dmarquez82/DCI-TP-INTEGRADOR/info/ESP32-S3-DevKitC 1 N16R8 PINOUT.jpg

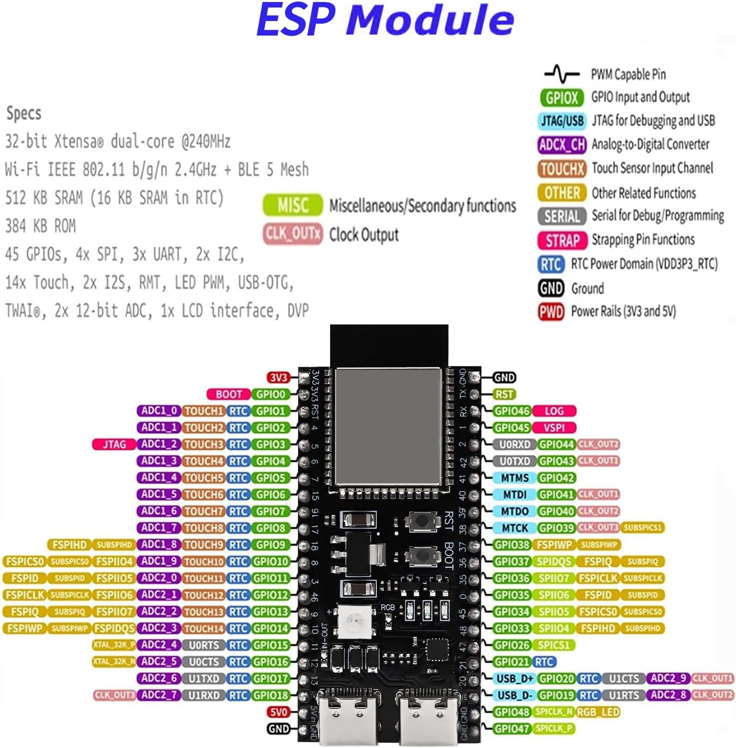
info/ESP32-S3-DevKitC 1 N16R8 PINOUT.jpg
