dmarquez82/DCI-TP-INTEGRADOR/pcb/Placa_Carrier_ESP32-S3-DEVKIT/3d/TerminalBlock_Phoenix_MKDS-1,5-3-5.08_1x03_P5.08mm_Horizontal.step

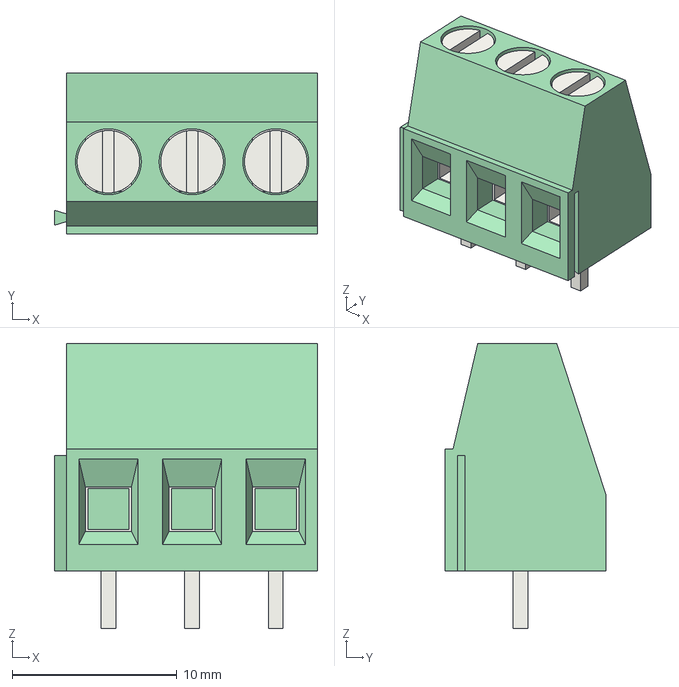
[picture p5: CAD file, 2026-11-07]
pcb/Placa_Carrier_ESP32-S3-DEVKIT/3d/TerminalBlock_Phoenix_MKDS-1,5-3-5.08_1x03_P5.08mm_Horizontal.step
16.0 x 9.80 x 17.3 mm
