dmarquez82/DCI-TP-INTEGRADOR/pcb/Placa_Carrier_ESP32-S3-DEVKIT/3d/C_0805_2012Metric.step

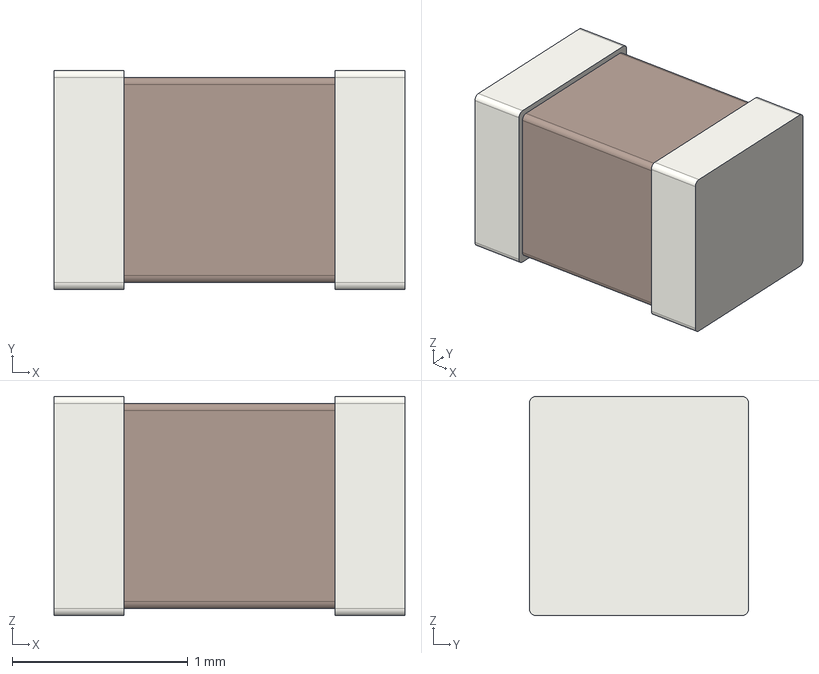
[picture p6: CAD file, 2026-11-07]
pcb/Placa_Carrier_ESP32-S3-DEVKIT/3d/C_0805_2012Metric.step
2.00 x 1.25 x 1.25 mm
