dmarquez82/DCI-TP-INTEGRADOR/pcb/Placa_Carrier_ESP32-S3-DEVKIT/3d/CP_Elec_6.3x7.7.step

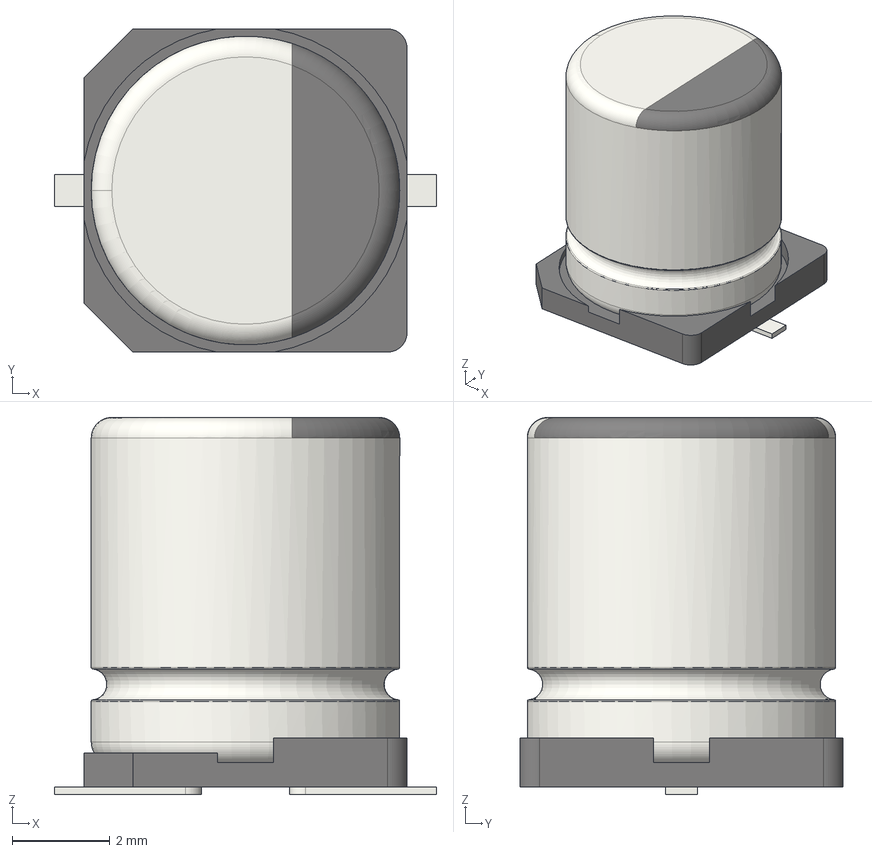
[picture p8: CAD file, 2026-11-07]
pcb/Placa_Carrier_ESP32-S3-DEVKIT/3d/CP_Elec_6.3x7.7.step
7.80 x 6.60 x 7.70 mm
