dmarquez82/DCI-TP-INTEGRADOR/pcb/Placa_Carrier_ESP32-S3-DEVKIT/3d/D_SOD-123.step

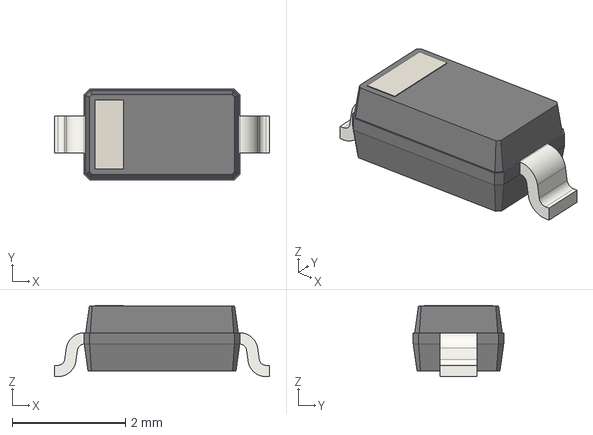
[picture p9: CAD file, 2026-11-07]
pcb/Placa_Carrier_ESP32-S3-DEVKIT/3d/D_SOD-123.step
3.80 x 1.60 x 1.26 mm
