dmarquez82/DCI-TP-INTEGRADOR/pcb/Placa_Carrier_ESP32-S3-DEVKIT/3d/TestPoint_Loop_D2.50mm_Drill1.0mm.step

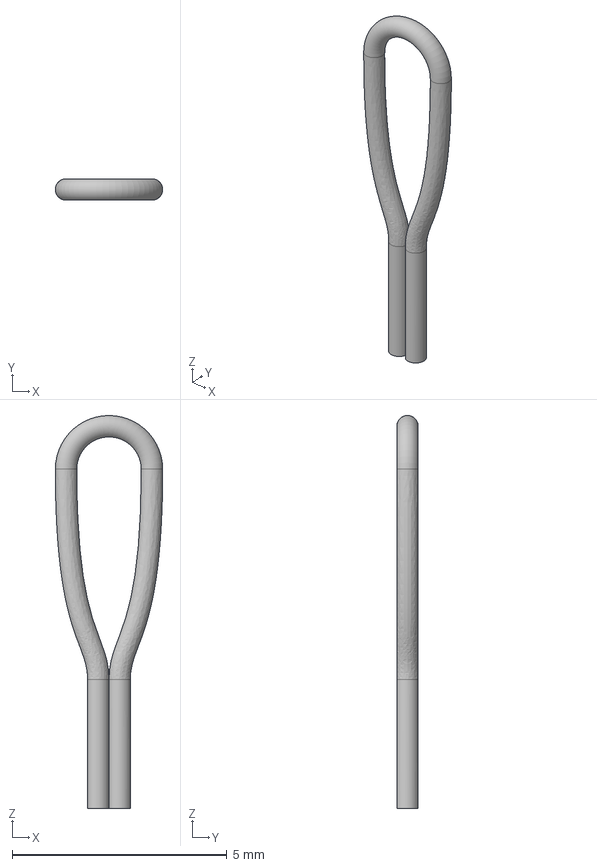
[picture p10: CAD file, 2026-11-07]
pcb/Placa_Carrier_ESP32-S3-DEVKIT/3d/TestPoint_Loop_D2.50mm_Drill1.0mm.step
2.50 x 0.5 x 9.15 mm
