dmarquez82/DCI-TP-INTEGRADOR/pcb/Placa_Carrier_ESP32-S3-DEVKIT/3d/PinHeader_1x02_P2.54mm_Vertical.step

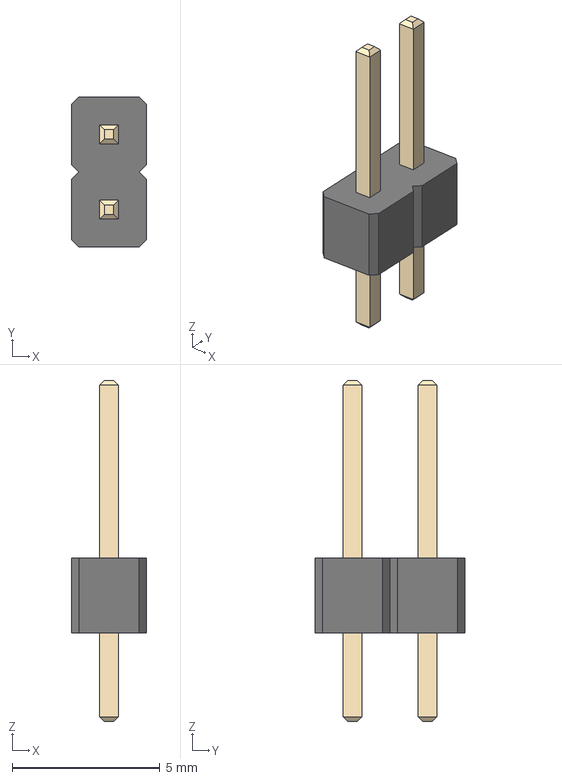
[picture p11: CAD file, 2026-11-07]
pcb/Placa_Carrier_ESP32-S3-DEVKIT/3d/PinHeader_1x02_P2.54mm_Vertical.step
2.54 x 5.08 x 11.5 mm
