dmarquez82/DCI-TP-INTEGRADOR/pcb/Placa_Carrier_ESP32-S3-DEVKIT/3d/CP_EIA-3528-21_Kemet-B.step

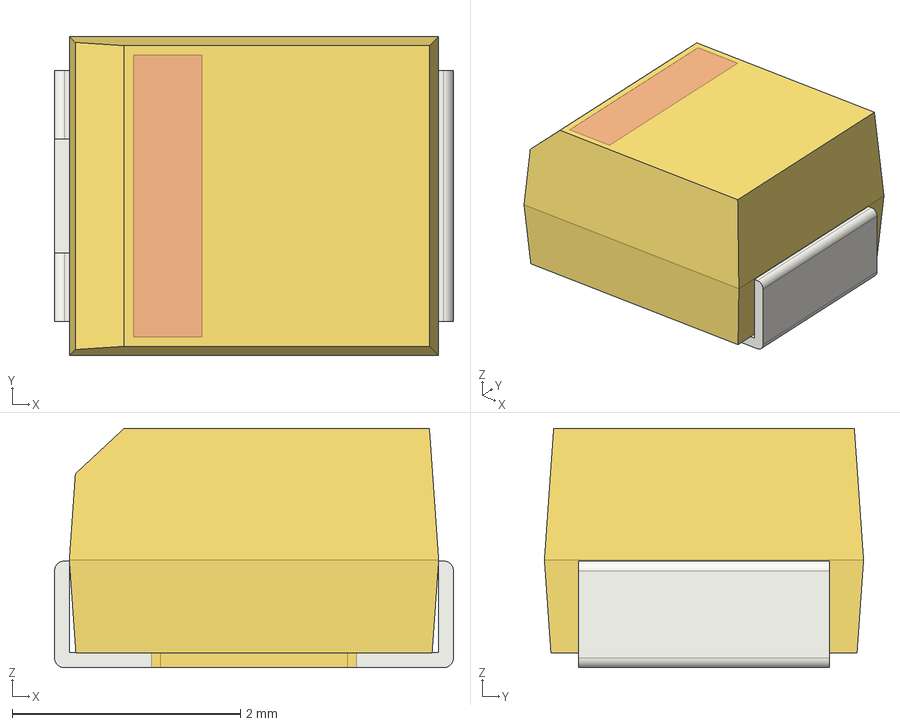
[picture p15: CAD file, 2026-11-07]
pcb/Placa_Carrier_ESP32-S3-DEVKIT/3d/CP_EIA-3528-21_Kemet-B.step
3.50 x 2.80 x 2.10 mm
