dmarquez82/DCI-TP-INTEGRADOR/pcb/Placa_Carrier_ESP32-S3-DEVKIT/3d/SW_PUSH_6mm.step

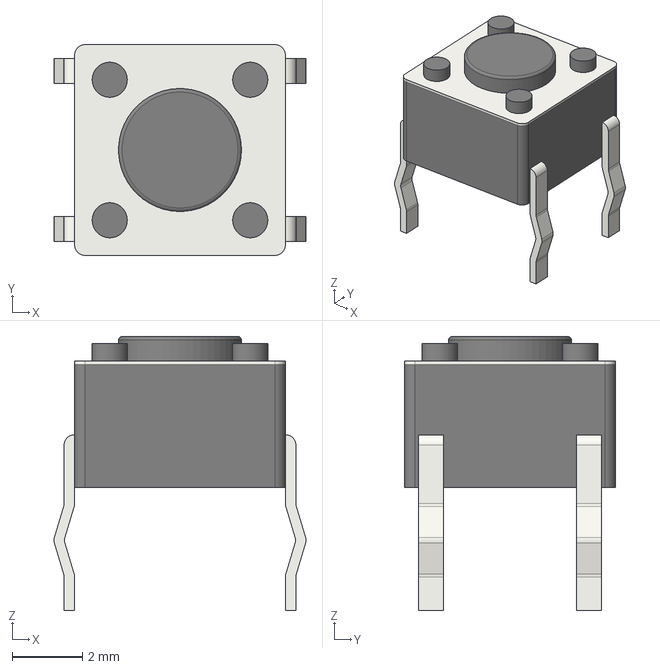
[picture p16: CAD file, 2026-11-07]
pcb/Placa_Carrier_ESP32-S3-DEVKIT/3d/SW_PUSH_6mm.step
7.17 x 6.00 x 7.80 mm
