dmarquez82/DCI-TP-INTEGRADOR/pcb/Placa_Carrier_ESP32-S3-DEVKIT/3d/R_1206_3216Metric.step

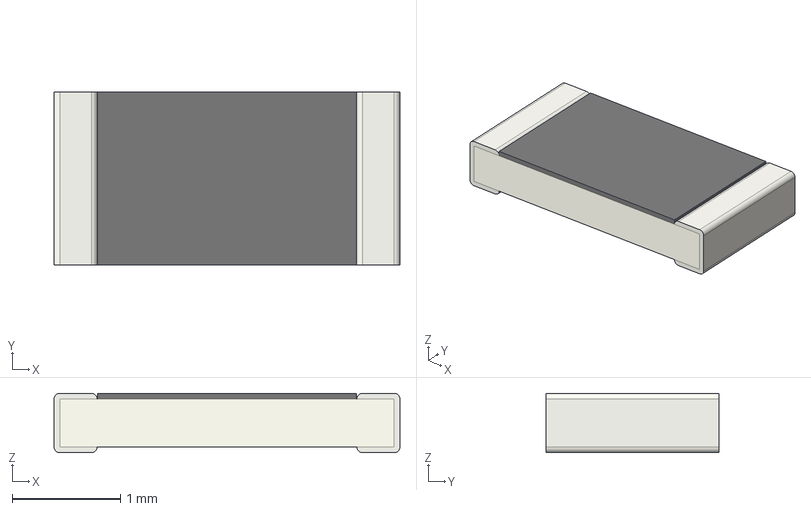
[picture p19: CAD file, 2026-11-07]
pcb/Placa_Carrier_ESP32-S3-DEVKIT/3d/R_1206_3216Metric.step
3.20 x 1.60 x 0.55 mm
