dmarquez82/DCI-TP-INTEGRADOR/pcb/Placa_Carrier_ESP32-S3-DEVKIT/3d/PinSocket_1x22_P2.54mm_Vertical.step

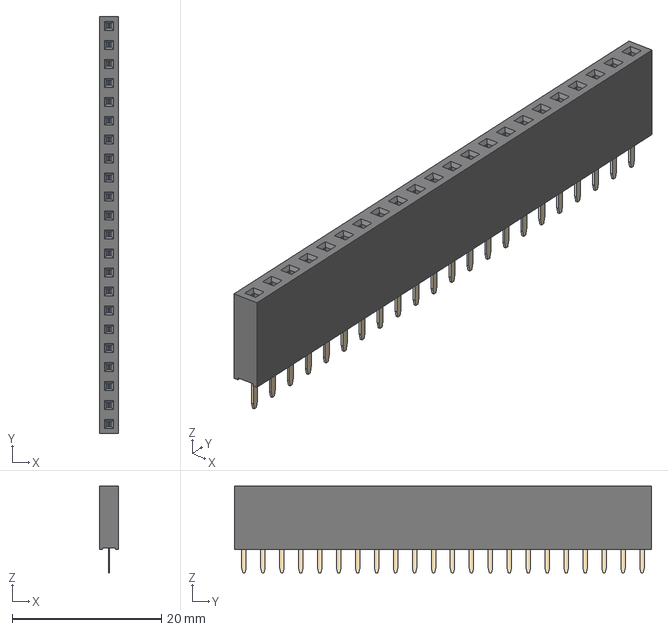
[picture p20: CAD file, 2026-11-07]
pcb/Placa_Carrier_ESP32-S3-DEVKIT/3d/PinSocket_1x22_P2.54mm_Vertical.step
2.54 x 55.9 x 11.6 mm
