dmarquez82/DCI-TP-INTEGRADOR/pcb/Placa_Carrier_ESP32-S3-DEVKIT/3d/Aosong_DHT11_5.5x12.0_P2.54mm.step

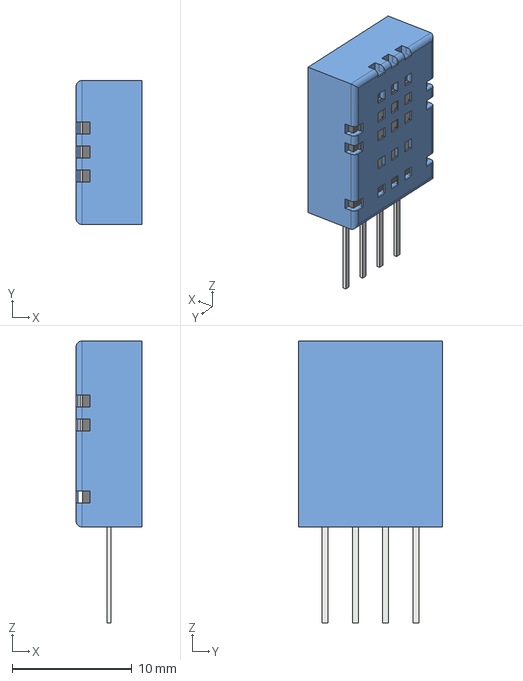
[picture p21: CAD file, 2026-11-07]
pcb/Placa_Carrier_ESP32-S3-DEVKIT/3d/Aosong_DHT11_5.5x12.0_P2.54mm.step
5.50 x 12.0 x 23.5 mm
