dmarquez82/DCI-TP-INTEGRADOR/pcb/Placa_Carrier_ESP32-S3-DEVKIT/3d/Relay_SPDT_SANYOU_SRD_Series_Form_C.step

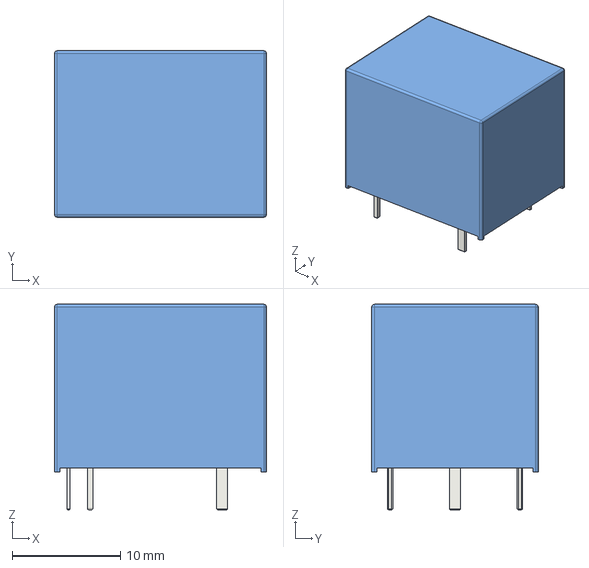
[picture p23: CAD file, 2026-11-07]
pcb/Placa_Carrier_ESP32-S3-DEVKIT/3d/Relay_SPDT_SANYOU_SRD_Series_Form_C.step
19.6 x 15.4 x 19.0 mm
