dmarquez82/DCI-TP-INTEGRADOR/info/PDF Kicad/Placa_Carrier_ESP32-S3-DEVKIT.pdf

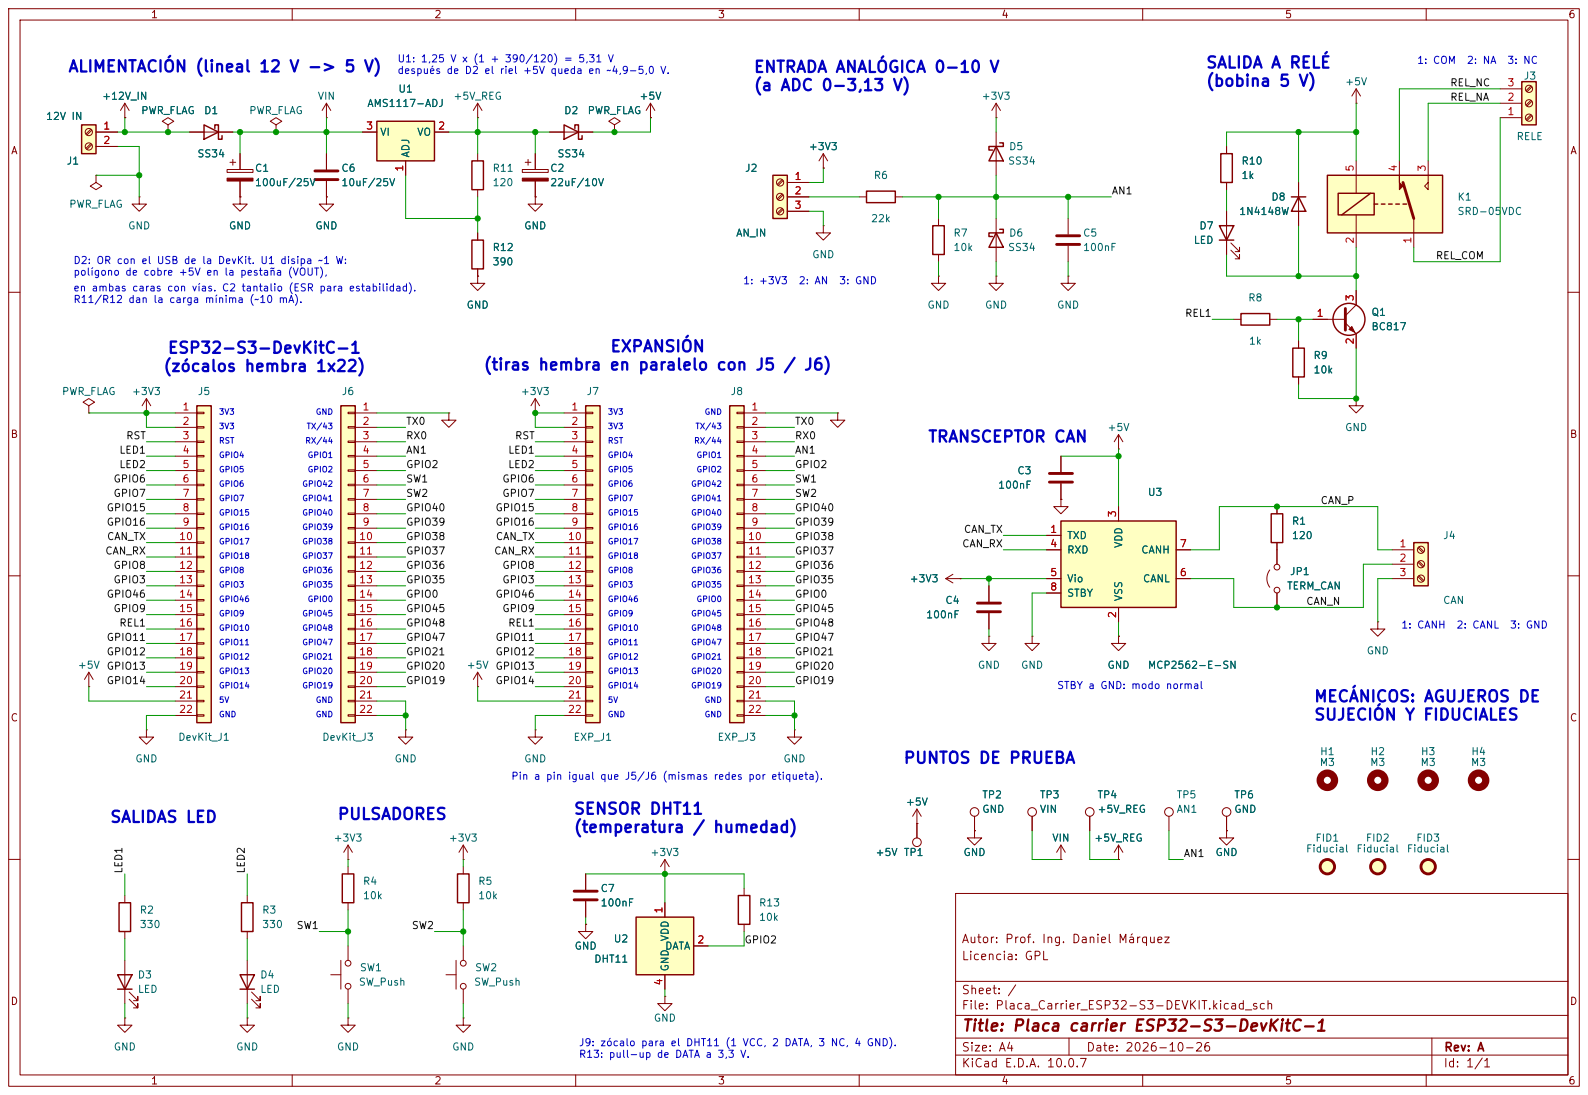
[picture p24: page 1]

U1: 1,25 V x (1 + 390/120) = 5,31 V después de D2 el riel +5V queda en ~4,9-5,0 V. EXPANSIÓN

TX/43 en ambas caras con vías. C2 tantalio (ESR para estabilidad).
R11/R12 dan la carga mínima (~10 mA).GPIO42 ESP32-S3-DevKitC-1

(tiras hembra en paralelo con J5 / J6)

GPIO14 Pin a pin igual que J5/J6 (mismas redes por etiqueta).

STBY a GND: modo normal PUNTOS DE PRUEBA

Autor: Prof. Ing. Daniel Márquez
Licencia: GPL

Sheet: /
File: Placa_Carrier_ESP32-S3-DEVKIT.kicad_sch
Title: Placa carrier ESP32-S3-DevKitC-1

J9: zócalo para el DHT11 (1 VCC, 2 DATA, 3 NC, 4 GND). R13: pull-up de DATA a 3,3 V.

Size: A4 | Rev: A
KiCad E.D.A. 10.0.7 | Id: 1/1
