dmarquez82/DCI-TP-INTEGRADOR/pcb/Placa_Carrier_ESP32-S3-DEVKIT/Placa_Carrier_ESP32-S3-DEVKIT.kicad_pcb

## KiCad design pcb/Placa_Carrier_ESP32-S3-DEVKIT/Placa_Carrier_ESP32-S3-DEVKIT.kicad_pcb (2026-11-07)

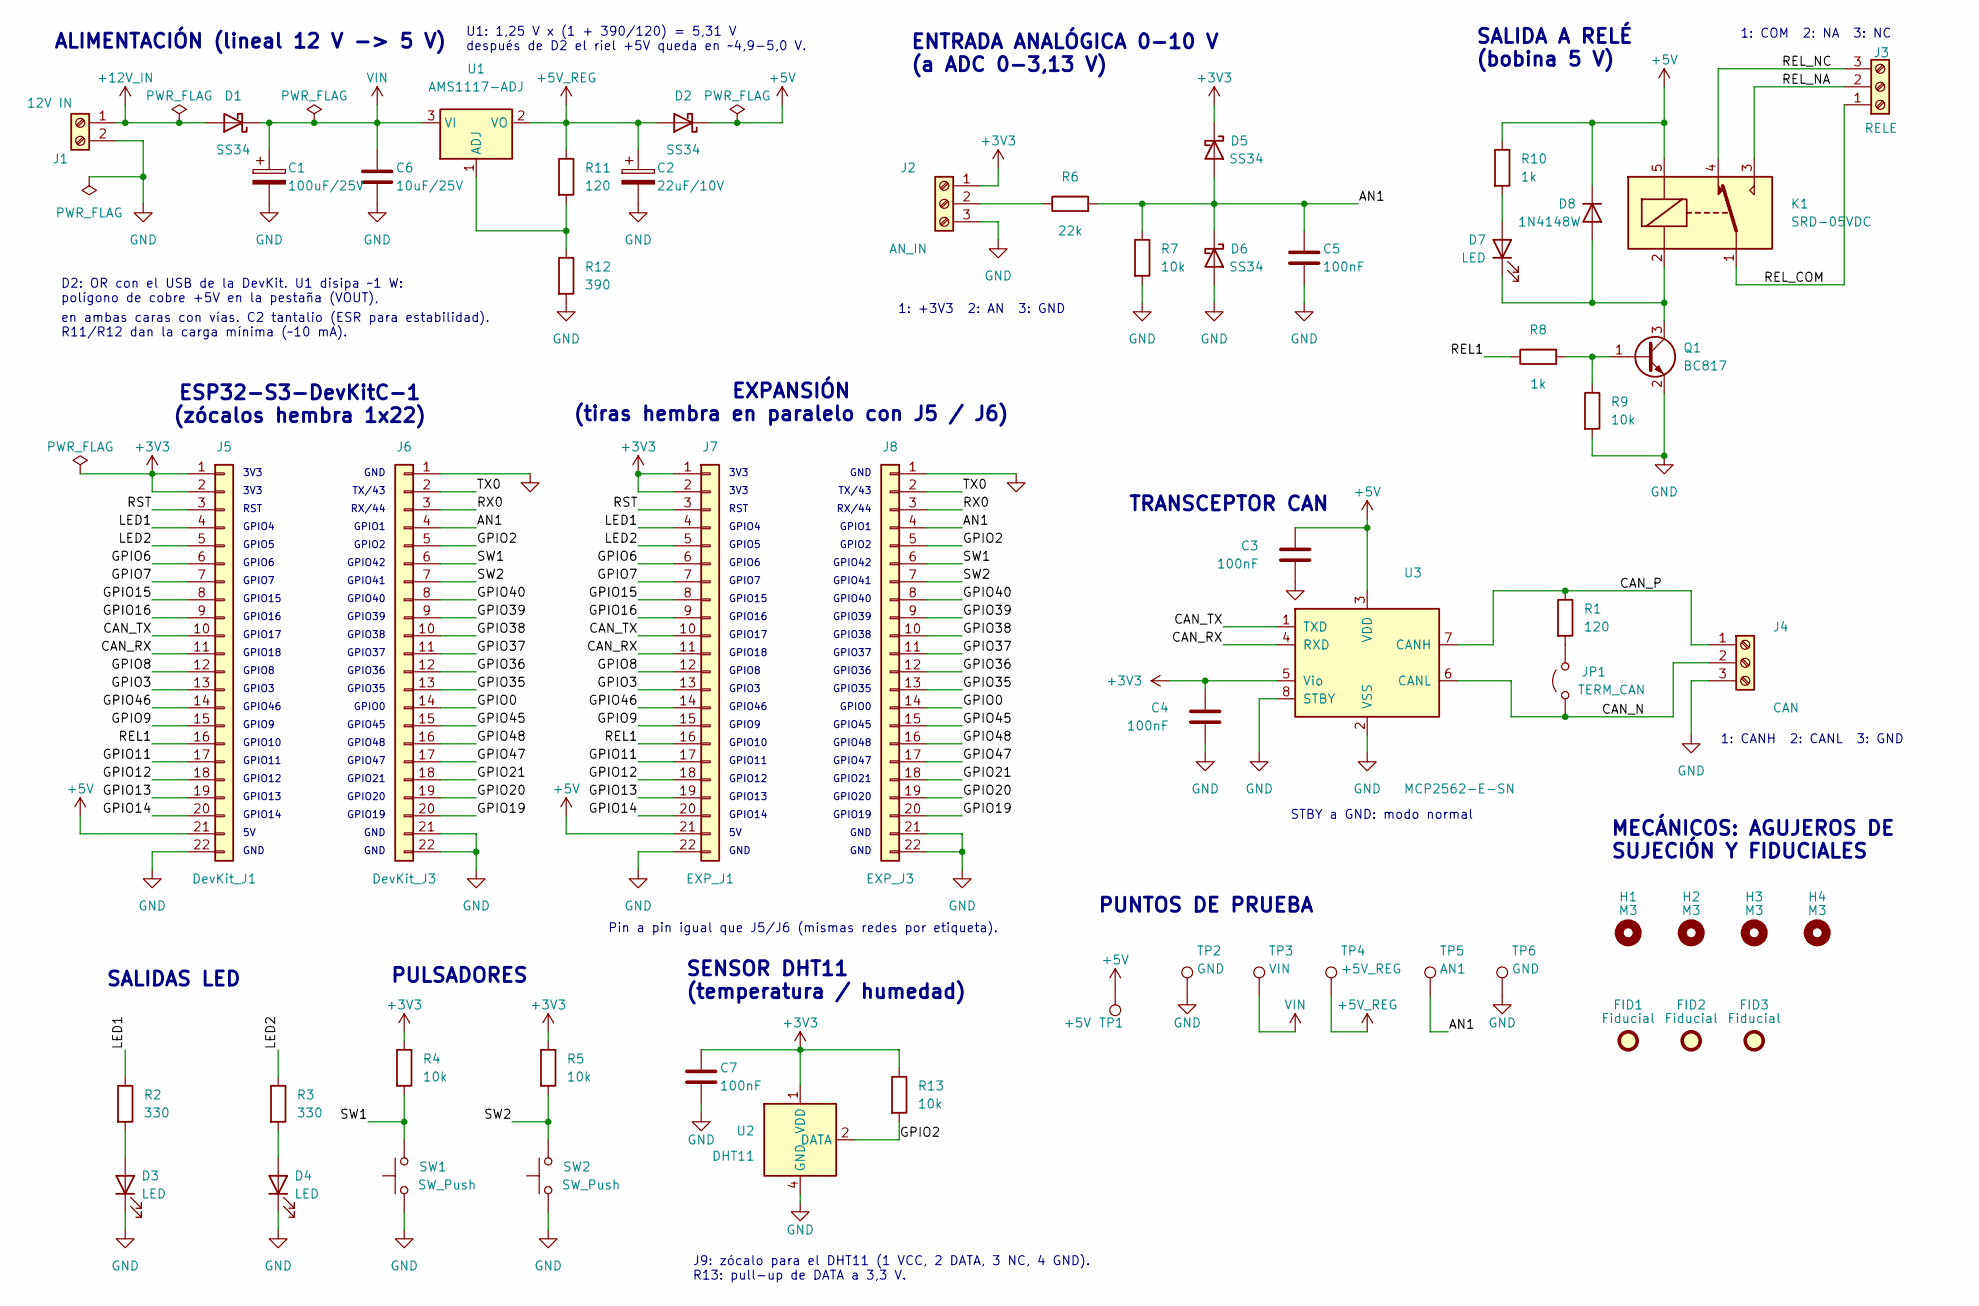
[picture p25: schematic Placa_Carrier_ESP32-S3-DEVKIT.kicad_sch, Placa carrier ESP32-S3-DevKitC-1]

Parts:
C1: 100uF/25V; CP_Elec_6.3x7.7
C2: 22uF/10V; CP_EIA-3528-21_Kemet-B
C3, C4, C5, C7: 100nF; C_0805_2012Metric_Pad1.18x1.45mm_HandSolder
C6: 10uF/25V; C_1206_3216Metric_Pad1.33x1.80mm_HandSolder
D1, D2, D5, D6: SS34; D_SMA
D3, D4, D7: LED; LED_1206_3216Metric_Pad1.42x1.75mm_HandSolder
D8: 1N4148W; D_SOD-123
FID1, FID2, FID3: Fiducial; Fiducial_1mm_Mask2mm
H1, H2, H3, H4: M3; MountingHole_3.2mm_M3
J1: 12V IN; TerminalBlock_Phoenix_MKDS-1,5-2-5.08_1x02_P5.08mm_Horizont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
J2: AN_IN; TerminalBlock_Phoenix_MKDS-1,5-3-5.08_1x03_P5.08mm_Horizont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
J3: RELE; TerminalBlock_Phoenix_MKDS-1,5-3-5.08_1x03_P5.08mm_Horizont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
J4: CAN; TerminalBlock_Phoenix_MKDS-1,5-3-5.08_1x03_P5.08mm_Horizont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
J5: DevKit_J1; PinSocket_1x22_P2.54mm_Vertical
J6: DevKit_J3; PinSocket_1x22_P2.54mm_Vertical
J7: EXP_J1; PinSocket_1x22_P2.54mm_Vertical
J8: EXP_J3; PinSocket_1x22_P2.54mm_Vertical
JP1: TERM_CAN; PinHeader_1x02_P2.54mm_Vertical
K1: SRD-05VDC; Relay_SPDT_SANYOU_SRD_Series_Form_C
Q1: BC817; SOT-23
R1, R11: 120; R_1206_3216Metric_Pad1.30x1.75mm_HandSolder
R2, R3: 330; R_1206_3216Metric_Pad1.30x1.75mm_HandSolder
R4, R5, R7, R9, R13: 10k; R_1206_3216Metric_Pad1.30x1.75mm_HandSolder
R6: 22k; R_1206_3216Metric_Pad1.30x1.75mm_HandSolder
R8, R10: 1k; R_1206_3216Metric_Pad1.30x1.75mm_HandSolder
R12: 390; R_1206_3216Metric_Pad1.30x1.75mm_HandSolder
SW1, SW2: SW_Push; SW_PUSH_6mm
TP1: +5V; TestPoint_Keystone_5000-5004_Miniature
TP2, TP6: GND; TestPoint_Keystone_5000-5004_Miniature
TP3: VIN; TestPoint_Keystone_5000-5004_Miniature
TP4: +5V_REG; TestPoint_Keystone_5000-5004_Miniature
TP5: AN1; TestPoint_Keystone_5000-5004_Miniature
U1: AMS1117-ADJ; SOT-223-3_TabPin2
U2: DHT11; Aosong_DHT11_5.5x12.0_P2.54mm
U3: MCP2562-E-SN; SOIC-8_3.9x4.9mm_P1.27mm

Connections:
+3V3: C4.1, C7.1, D5.1 (K), J2.1, J5.1, J5.2, J7.1, J7.2, R4.1, R5.1, R13.1, U2.1 (VDD), U3.5 (Vio)
+5V: C3.1, D2.1 (K), D8.1 (K), J5.21, J7.21, K1.5, R10.1, TP1.1 (1_1), U3.3 (VDD)
+5V_REG: C2.1, D2.2 (A), R11.1, TP4.1 (1_1), U1.2 (VO)
+12V_IN: D1.2 (A), J1.1
/AN1: C5.1, D5.2 (A), D6.1 (K), J6.4, J8.4, R6.2, R7.1, TP5.1 (1_1)
/CAN_N: J4.2, JP1.1 (A), U3.6 (CANL)
/CAN_P: J4.1, R1.1, U3.7 (CANH)
/CAN_RX: J5.11, J7.11, U3.4 (RXD)
/CAN_TX: J5.10, J7.10, U3.1 (TXD)
/GPIO0: J6.14, J8.14
/GPIO2: J6.5, J8.5, R13.2, U2.2 (DATA)
/GPIO3: J5.13, J7.13
/GPIO6: J5.6, J7.6
/GPIO7: J5.7, J7.7
/GPIO8: J5.12, J7.12
/GPIO9: J5.15, J7.15
/GPIO11: J5.17, J7.17
/GPIO12: J5.18, J7.18
/GPIO13: J5.19, J7.19
/GPIO14: J5.20, J7.20
/GPIO15: J5.8, J7.8
/GPIO16: J5.9, J7.9
/GPIO19: J6.20, J8.20
/GPIO20: J6.19, J8.19
/GPIO21: J6.18, J8.18
/GPIO35: J6.13, J8.13
/GPIO36: J6.12, J8.12
/GPIO37: J6.11, J8.11
/GPIO38: J6.10, J8.10
/GPIO39: J6.9, J8.9
/GPIO40: J6.8, J8.8
/GPIO45: J6.15, J8.15
/GPIO46: J5.14, J7.14
/GPIO47: J6.17, J8.17
/GPIO48: J6.16, J8.16
/LED1: J5.4, J7.4, R2.1
/LED2: J5.5, J7.5, R3.1
/REL1: J5.16, J7.16, R8.1
/REL_COM: J3.1, K1.1
/REL_NA: J3.2, K1.3
/REL_NC: J3.3, K1.4
/RST: J5.3, J7.3
/RX0: J6.3, J8.3
/SW1: J6.6, J8.6, R4.2, SW1.2
/SW2: J6.7, J8.7, R5.2, SW2.2
/TX0: J6.2, J8.2
GND: C1.2, C2.2, C3.2, C4.2, C5.2, C6.2, C7.2, D3.1 (K), D4.1 (K), D6.2 (A), J1.2, J2.3, J4.3, J5.22, J6.1, J6.21, J6.22, J7.22, J8.1, J8.21, J8.22, Q1.2 (E), R7.2, R9.2, R12.2, SW1.1, SW2.1, TP2.1 (1_1), TP6.1 (1_1), U2.4 (GND), U3.2 (VSS), U3.8 (STBY)
unnamed: D3.2 (A), R2.2
unnamed: D4.2 (A), R3.2
unnamed: D7.2 (A), R10.2
unnamed: D7.1 (K), D8.2 (A), K1.2, Q1.3 (C)
unnamed: J2.2, R6.1
unnamed: JP1.2 (B), R1.2
unnamed: Q1.1 (B), R8.2, R9.1
unnamed: R11.2, R12.1, U1.1 (ADJ)
VIN: C1.1, C6.1, D1.1 (K), TP3.1 (1_1), U1.3 (VI)

Notes on the sheet:
GPIO39
GPIO38
GPIO45
GPIO15
GPIO47
Pin a pin igual que J5/J6 (mismas redes por etiqueta).
GPIO13
GPIO12
GPIO10
SALIDA A RELÉ (bobina 5 V)
GPIO2
TX/43
GPIO20
GND
GPIO17
1: CANH 2: CANL 3: GND
GPIO42
GPIO1
GPIO41
SENSOR DHT11 (temperatura / humedad)
3V3
SALIDAS LED
GPIO36
GPIO46
GPIO35
ENTRADA ANALÓGICA 0-10 V (a ADC 0-3,13 V)
GPIO19
D2: OR con el USB de la DevKit. U1 disipa ~1 W: polígono de cobre +5V en la pestaña (VOUT),
GPIO18
GPIO7
1: +3V3 2: AN 3: GND
ESP32-S3-DevKitC-1 (zócalos hembra 1x22)
GPIO8
GPIO9
GPIO5
GPIO37
GPIO40
TRANSCEPTOR CAN
EXPANSIÓN (tiras hembra en paralelo con J5 / J6)
1: COM 2: NA 3: NC
GPIO3
GPIO16
GPIO6
GPIO21
PULSADORES
MECÁNICOS: AGUJEROS DE SUJECIÓN Y FIDUCIALES
ALIMENTACIÓN (lineal 12 V -> 5 V)
GPIO11
en ambas caras con vías. C2 tantalio (ESR para estabilidad). R11/R12 dan la carga mínima (~10 mA).
RX/44
RST
GPIO48
GPIO0
GPIO4
J9: zócalo para el DHT11 (1 VCC, 2 DATA, 3 NC, 4 GND). R13: pull-up de DATA a 3,3 V.
GPIO14
U1: 1,25 V x (1 + 390/120) = 5,31 V después de D2 el riel +5V queda en ~4,9-5,0 V.
PUNTOS DE PRUEBA
STBY a GND: modo normal

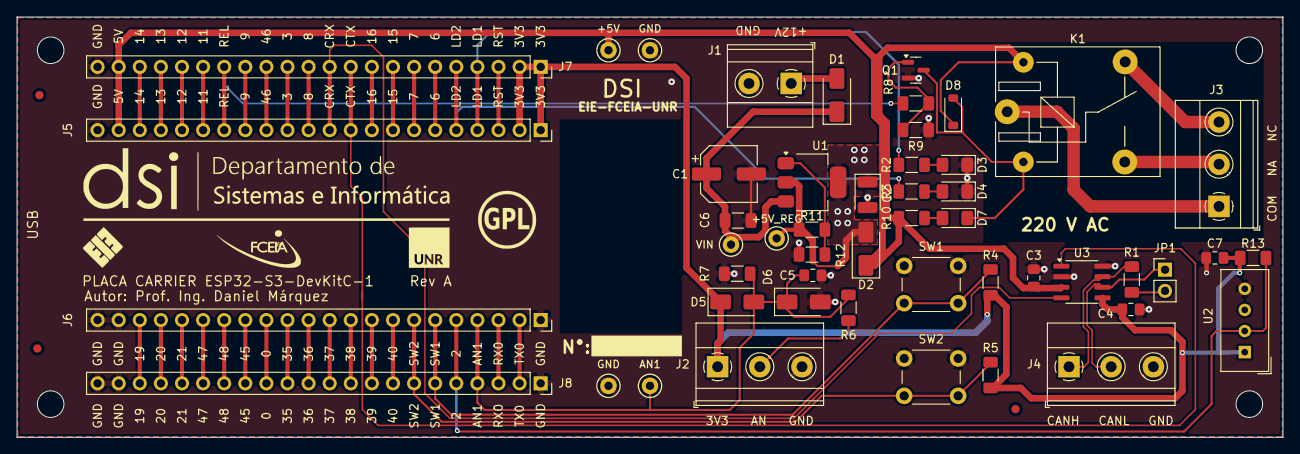
[picture p26: board Placa_Carrier_ESP32-S3-DEVKIT.kicad_pcb from above]

Board: 2 copper layers, 152.4 x 50.6 mm, 57 parts (0 on the bottom side), 56 nets.
