dmarquez82/DCI-TP-INTEGRADOR/(commit log)

2026-10-26 Crea proyecto KiCad
    [Placa_Carrier_ESP32-S3-DEVKIT.kicad_pcb, Placa_Carrier_ESP32-S3-DEVKIT.kicad_sch]
2026-10-27 Actualiza sch y PCB
    [Placa_Carrier_ESP32-S3-DEVKIT.kicad_pcb, Placa_Carrier_ESP32-S3-DEVKIT.kicad_sch]
2026-10-27 Actualiza hoja de datos e info
2026-10-27 Actualiza ruteo
    [Placa_Carrier_ESP32-S3-DEVKIT.kicad_pcb]
2026-10-27 actualiza ruteo con par diferencial
    [Placa_Carrier_ESP32-S3-DEVKIT.kicad_pcb, Placa_Carrier_ESP32-S3-DEVKIT.kicad_sch]
2026-10-27 Actualiza PCB
    [Placa_Carrier_ESP32-S3-DEVKIT.kicad_pcb]
2026-10-30 actualiza sch
    [Placa_Carrier_ESP32-S3-DEVKIT.kicad_sch]
2026-10-30 Empieza a cambiar hoja a A4
    [Placa_Carrier_ESP32-S3-DEVKIT.kicad_pcb, Placa_Carrier_ESP32-S3-DEVKIT.kicad_sch]
2026-10-30 Hoja de sch pasada a A4
    [Placa_Carrier_ESP32-S3-DEVKIT.kicad_sch]
2026-10-30 Sube PCB ruteado sin refinar
    [Placa_Carrier_ESP32-S3-DEVKIT.kicad_pcb]
2026-10-31 Completa README, licencia GPL-3.0 y propuesta
    - README: título, descripción del circuito y sección de licencia.
    - LICENSE: texto completo de la GPL v3.
    - doc/propuesta/README.md: objetivo, módulo de referencia y enlaces a las imágenes.
    - .gitignore para archivos temporales de KiCad; se deja de versionar el .kicad_prl.
2026-10-31 Agrega Logo DSI y GPL en PCB
    [Placa_Carrier_ESP32-S3-DEVKIT.kicad_pcb]
2026-10-31 saca un texto de silkscreen
    [Placa_Carrier_ESP32-S3-DEVKIT.kicad_pcb]
2026-11-01 Mejora ruteo
    [Placa_Carrier_ESP32-S3-DEVKIT.kicad_pcb]
2026-11-02 Agrega sensor DHT11
    [Placa_Carrier_ESP32-S3-DEVKIT.kicad_pcb, Placa_Carrier_ESP32-S3-DEVKIT.kicad_sch]
2026-11-02 Actualiza footprint y simbolo del DHT11
    [Placa_Carrier_ESP32-S3-DEVKIT.kicad_pcb, Placa_Carrier_ESP32-S3-DEVKIT.kicad_sch]
2026-11-02 acomoda DHT11
    [Placa_Carrier_ESP32-S3-DEVKIT.kicad_pcb]
2026-11-02 Se acomodan componentes del DHT11
    [Placa_Carrier_ESP32-S3-DEVKIT.kicad_pcb]
2026-11-02 Acomoda serigrafía
    [Placa_Carrier_ESP32-S3-DEVKIT.kicad_pcb]
2026-11-02 acomoda componetes por error de DRC
    [Placa_Carrier_ESP32-S3-DEVKIT.kicad_pcb]
2026-11-02 acomoda serigrafia
    [Placa_Carrier_ESP32-S3-DEVKIT.kicad_pcb]
2026-11-02 Agrega PDF del sch en la carpeta info
2026-11-06 actualiza readme
    Updated project description to include DHT11 sensor.
2026-11-06 Actualiza sch con planilla de revisión
    [Placa_Carrier_ESP32-S3-DEVKIT.kicad_sch]
2026-11-06 Actualiza fiduciales, sujeciones en SCH y vincula con PCB
    [Placa_Carrier_ESP32-S3-DEVKIT.kicad_pcb, Placa_Carrier_ESP32-S3-DEVKIT.kicad_sch]
2026-11-06 actualiza PCB con fiducial
    [Placa_Carrier_ESP32-S3-DEVKIT.kicad_pcb]
2026-11-06 Actualiza PDF del sch con fiduciales, sujeciones y power flags
2026-11-07 Sube al repo los modelos 3D
    [Aosong_DHT11_5.5x12.0_P2.54mm.step, CP_EIA-3528-21_Kemet-B.step, CP_Elec_6.3x7.7.step, C_0805_2012Metric.step, C_1206_3216Metric.step, D_SMA.step, D_SOD-123.step, LED_1206_3216Metric.step]
2026-11-07 Actualiza PCB para que busque modelos 3D en carpeta de proyecto
    [Placa_Carrier_ESP32-S3-DEVKIT.kicad_pcb]
2026-11-07 Corrige PCB
    [Placa_Carrier_ESP32-S3-DEVKIT.kicad_pcb]
2026-11-07 sube hoja de datos del DHT11
2026-11-07 Actualiza PCB con notas de fabricación y cotas
    [Placa_Carrier_ESP32-S3-DEVKIT.kicad_pcb]
2026-11-07 Dibuja margende seguridad en el PCB
    [Placa_Carrier_ESP32-S3-DEVKIT.kicad_pcb]
