dmarquez82/DCI-TP-INTEGRADOR/(notices)

Notices in the files:
pcb/Placa_Carrier_ESP32-S3-DEVKIT/3d/C_1206_3216Metric.step:
Copyright (C) 2017, kicad StepUp
This work is licensed under the [Creative Commons CC-BY-SA 4.0 License](https://creativecommons.org/licenses/by-sa/4.0/legalcode),
with the following exception:
To the extent that the creation of electronic designs that use 'Licensed Material' can be considered to be 'Adapted Material',
You are free to use the library data in your own projects without the obligation to share your project files under this or any other license agreement.
pcb/Placa_Carrier_ESP32-S3-DEVKIT/3d/D_SMA.step:
This program is free software: you can redistribute it and/or modify
it under the terms of the GNU General Public License as published by
the Free Software Foundation, either version 3 of the License, or
any later version.
itself might be covered by the GNU General Public License.
pcb/Placa_Carrier_ESP32-S3-DEVKIT/3d/LED_1206_3216Metric.step:
Copyright (C) 2018, kicad StepUp
pcb/Placa_Carrier_ESP32-S3-DEVKIT/3d/SOIC-8_3.9x4.9mm_P1.27mm.step:
Copyright (C) 2025, KiCAD
This work is licensed under the
[Creative Commons CC-BY-SA 4.0 License](https://creativecommons.org/licenses/by-sa/4.0/legalcode),
project files under this or any other license agreement. However, if you wish to distribute
pcb/Placa_Carrier_ESP32-S3-DEVKIT/3d/Relay_SPDT_SANYOU_SRD_Series_Form_C.step:
Copyright (C) 2019, kicad StepUp
pcb/Placa_Carrier_ESP32-S3-DEVKIT/3d/PinSocket_1x22_P2.54mm_Vertical.step:
Copyright (C) 2024, KiCAD
pcb/Placa_Carrier_ESP32-S3-DEVKIT/3d/TerminalBlock_Phoenix_MKDS-1,5-3-5.08_1x03_P5.08mm_Horizontal.step:
Copyright (C) 2026, KiCAD
